jinchengXie99/FOC_v0.1/开发记录日志.md

# 浩盛单路电机开发板 V2.0 硬件驱动与 FOC 控制配置记录

> **文档版本**：V2.0  
> **生成日期**：2026-10-20  
> **MCU 型号**：STM32G431RBT6（LQFP64，170MHz，M4 内核带 FPU）  
> **开发环境**：STM32CubeMX + Keil MDK-ARM  
> **硬件版本**：浩盛单路电机开发板 V2.0

---

## 一、 硬件平台基本信息

| 模块 | 规格说明 |
| :--- | :--- |
| **MCU** | STM32G431RBT6，主频 170MHz，128KB Flash，32KB SRAM |
| **外部晶振** | 16 MHz（HSE） |
| **栅极驱动** | 4 × EG2104（单路 PWM 输入，内部自带互补死区，典型死区 100ns） |
| **功率级** | 4 个半桥（双 H 桥），MOSFET 型号 HYG025N06LS1C2，支持三相/步进电机 |
| **电流采样** | 下桥臂采样，A 相 (R28) 和 C 相 (R29)，采样电阻 **5mΩ** |
| **电流运放** | 外部运放 COS722MR，固定增益 **10 倍**，1.65V 基准偏置 |
| **母线电压** | R83 (100k) 与 R56 (4.7k) 分压，运放隔离，TVS (SMAJ40CA) 在 40V 钳位 |
| **其他外设** | 0.96 寸 SPI 彩屏、三色 LED、两个按键、NTC 测温、KTH7823 磁编码器（预留） |

---

## 二、 引脚分配总表

| 引脚 | 功能 | 外设/信号 | 说明 |
| :--- | :--- | :--- | :--- |
| **PC0** | TIM1_CH1 | PWMA | A 相 PWM，接 EG2104 #1 IN |
| **PC1** | TIM1_CH2 | PWMB | B 相 PWM，接 EG2104 #2 IN |
| **PC2** | TIM1_CH3 | PWMC | C 相 PWM，接 EG2104 #3 IN |
| **PC3** | TIM1_CH4 | PWMD | D 相 PWM（步进用）；同时产生 OC4REF 触发 ADC |
| **PA6** | ADC2_IN3 | 相电流 | 接 COS722MR 输出（具体对应 A/C 相按实物接线） |
| **PA4** | ADC2_IN17 | 相电流 | 接 COS722MR 输出（具体对应 A/C 相按实物接线） |
| **PC5** | ADC2_IN11 | V_BUS | 母线电压采样（**注意：UART1_RX 也是 PC5，当前未启用 RX，无冲突**） |
| **PA0** | GPIO Output | SD4 | EG2104 #4 使能（步进电机 D 桥臂） |
| **PA1** | GPIO Output | SD2 | EG2104 #2 使能（B 相） |
| **PA2** | GPIO Output | SD3 | EG2104 #3 使能（C 相） |
| **PB0** | GPIO Output | SD1 | EG2104 #1 使能（A 相） |
| **PC13** | GPIO Output | LED_B | 蓝色 LED（低电平点亮） |
| **PC14** | GPIO Output | LED_G | 绿色 LED（低电平点亮） |
| **PC15** | GPIO Output | LED_R | 红色 LED（低电平点亮） |
| **PC9** | GPIO Input | KEY1 | 按键 1（上拉，低电平按下，用于故障恢复） |
| **PB12** | GPIO Input | KEY2 | 按键 2（上拉） |
| **PB15** | ADC | TEMP | NTC 温度检测（预留） |
| **PB2** | ADC | ADC_IN | 波轮电位器（预留） |
| **PC4** | USART1_TX | TX | 调试串口发送（DMA） |
| **PC5** | USART1_RX | RX | 调试串口接收（**被母线采样占用，未启用**） |
| **PC10** | SPI3_SCK | SCK | LCD 时钟 |
| **PC12** | SPI3_MOSI | MOSI | LCD 数据 |
| **PA15** | GPIO Output | CS | LCD 片选 |
| **PC11** | GPIO Output | LCD_RST | LCD 复位 |
| **PD2** | GPIO Output | LCD_RS | LCD 数据/命令选择 |
| **PA13/PA14** | SWDIO/SWCLK | 调试 | 调试接口，PA14 不再用于 ADC |
| **PB3/PB4/PB5/PB9** | SPI1 | 预留 | 编码器 KTH7823 接口预留 |

---

## 三、 CubeMX 外设配置说明

### 3.1 系统时钟 (RCC)
*   **HSE**: 16 MHz 晶振
*   **PLLM** = 4, **PLLN** = 85, **PLLR** = 2
*   **SYSCLK** = 170 MHz，AHB/APB1/APB2 均为 /1 分频。

### 3.2 TIM1 (三相 PWM 与 ADC 触发)
*   **Clock Source**: Internal Clock
*   **Prescaler**: 0
*   **Counter Mode**: Center Aligned Mode 1
*   **Period (ARR)**: 4250（PWM 频率 20kHz）
*   **TRGO**: Disable（因为 ADC 直接使用 CH4 比较事件触发）
*   **Channel 1~4**: PWM Generation CH1~CH4，PWM Mode 1，Pulse=0，CH Polarity = High
*   **CH4 特殊配置**：`CCR4 = ARR - 1`，作为 ADC2 的上升沿触发源。
*   **死区配置**：无需配置（EG2104 内部硬件死区）。

### 3.3 ADC2 (电流采样与母线电压)
*   **时钟**：由系统时钟分频，确保不超过 60MHz。
*   **注入组 (Injected, 20kHz)**：
    *   触发源：**Timer 1 Capture Compare 4 event (TIM1_CC4)**，Rising Edge
    *   Rank 1：ADC2_IN3 (PA6)
    *   Rank 2：ADC2_IN17 (PA4)
    *   采样时间：12.5 或 15 cycles
    *   开启 `ADC1_2_IRQn` 中断。
*   **规则组 (Regular, 1kHz 软件触发)**：
    *   触发源：Software Trigger
    *   Rank 1：ADC2_IN11 (PC5，母线电压)
    *   采样时间：47.5 或 92.5 cycles
    *   连续转换模式：Disable

### 3.4 TIM2 (1kHz 控制环)
*   **Prescaler** = 16999，**Period** = 9
*   开启 `TIM2 global interrupt`，优先级低于 ADC 中断。

### 3.5 USART1 (调试串口)
*   **Baud Rate**: 921600
*   **Mode**: Asynchronous (TX only 或开启 RX，但物理引脚不接)
*   **DMA**: 添加 `USART1_TX`，Memory to Peripheral，Normal 模式。

---

## 四、 核心算法与控制逻辑

### 4.1 电流换算公式
*   **增益**：\(I = (ADC\_Value - Offset) \times \frac{3.3}{4096} \times \frac{1}{5m\Omega \times 10}\)
*   **换算系数**：`CURRENT_SCALE = 0.016113 A/LSB`
*   **零点偏置**：`ia_offset ≈ 1991`, `ic_offset ≈ 1971`（需在静止无电流时实测标定）。

### 4.2 母线电压换算公式
*   **分压比**：\(V_{pin} = V_{bus} \times \frac{4.7}{100 + 4.7}\)
*   **换算系数**：`VBUS_SCALE = 0.017947 V/LSB`

### 4.3 EG2104 驱动逻辑
| IN | SD | HO | LO | 半桥状态 |
| :--- | :--- | :--- | :--- | :--- |
| 0 | 0 | 0 | 0 | 全关（禁用） |
| 0 | 1 | 0 | 1 | 下管导通 |
| 1 | 0 | 0 | 0 | 全关（禁用） |
| 1 | 1 | 1 | 0 | 上管导通 |
*   *注意：SD 低电平有效。上电初始化和故障时，必须拉低 SD 引脚。*

### 4.4 保护机制
1.  **过流保护（在 ADC2 中断中执行）**：
    *   **硬阈值**（15.0A）：瞬间超过立即关断，不消抖。
    *   **软阈值**（8.0A）：连续 5 次（50μs 周期）超过才关断，抗噪声。
    *   故障动作：拉低所有 SD 引脚，PWM 占空比清零，红灯亮，锁存故障 `g_fault_latch = 1`。
2.  **过欠压保护（在 TIM2 中断中执行）**：
    *   **过压**：> 30.0V 触发（恢复阈值 29.0V）。
    *   **欠压**：< 10.0V 触发（恢复阈值 12.0V）。
    *   故障动作：同过流保护。
3.  **故障恢复**：需在主循环中判断，电流归零、电压在安全区间内，且按下 KEY1 后，才清除锁存并重新使能 SD 引脚。

### 4.5 上位机通信 (VOFA+ JustFloat)
*   **协议结构**：`typedef struct { float ch_data[N]; uint8_t tail[4]; } VOFA_Frame_t;`
*   **帧尾**：`{0x00, 0x00, 0x80, 0x7F}`。
*   **发送机制**：在 TIM2 (1kHz) 或降频的 ADC2 中断中，检查 `vofa_tx_busy` 标志，空闲时调用 `HAL_UART_Transmit_DMA`。在 `HAL_UART_TxCpltCallback` 中清除忙标志。

---

## 五、 当前进度与后续计划

### 已完成进度：
- [x] 硬件引脚映射与 CubeMX 底层配置。
- [x] 20kHz PWM 产生、ADC2 注入组电流采样、1kHz 规则组电压采样。
- [x] VOFA+ 波形协议打通。
- [x] V/F 开环控制验证成功（电机可转动）。
- [x] 过流、过压、欠压软件保护逻辑实现。
- [x] I/F（电流闭环，频率开环）代码编写。

### 后续开发计划：
1. **I/F 调试**：观察 \(I_d, I_q\) 波形，调整 PI 参数，验证电机输出力矩。
2. **编码器接入**：启用 KTH7823（SPI/ABZ），获取精确电角度与转速。
3. **有感 FOC 闭环**：实现速度环与电流环的双闭环控制。
4. **硬件级保护（可选）**：接入 STM32 内部 COMP 比较器，触发 TIM1 BKIN 硬件刹车，实现微秒级短路保护。
