jinchengXie99/FOC_v0.1/Hardware/tb_image_share_1756172024298.jpg.png

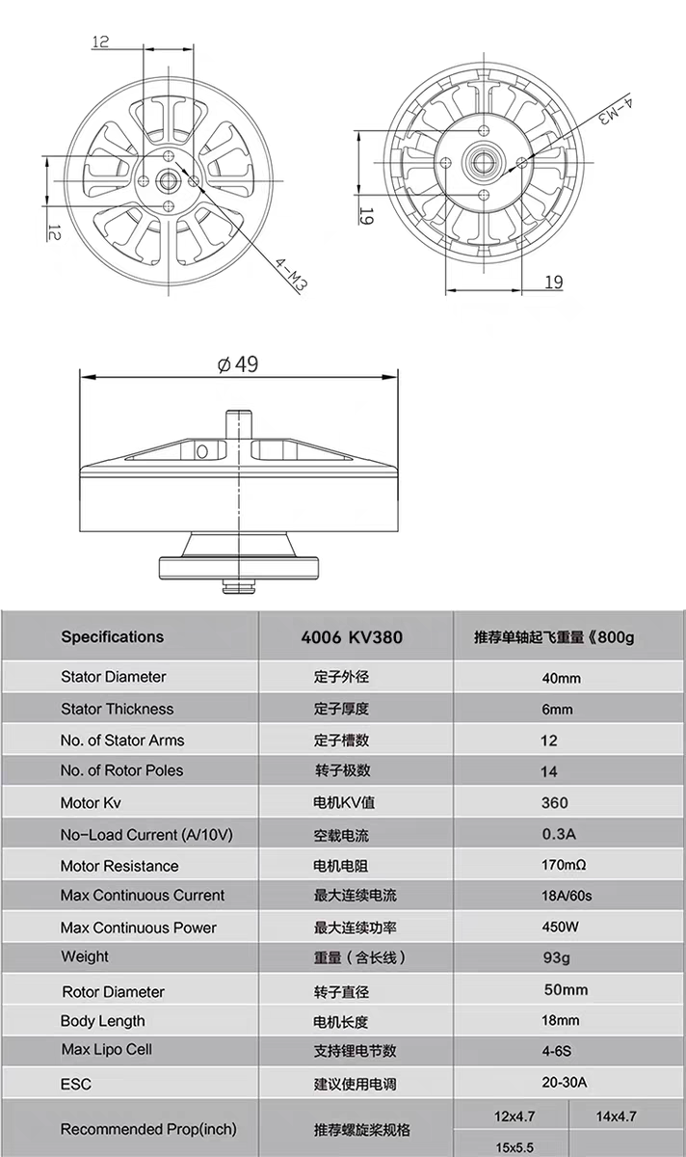
Hardware/tb_image_share_1756172024298.jpg.png
