jinchengXie99/FOC_v0.1/Hardware/浩盛电机开发板支架SLDPRT.SLDPRT

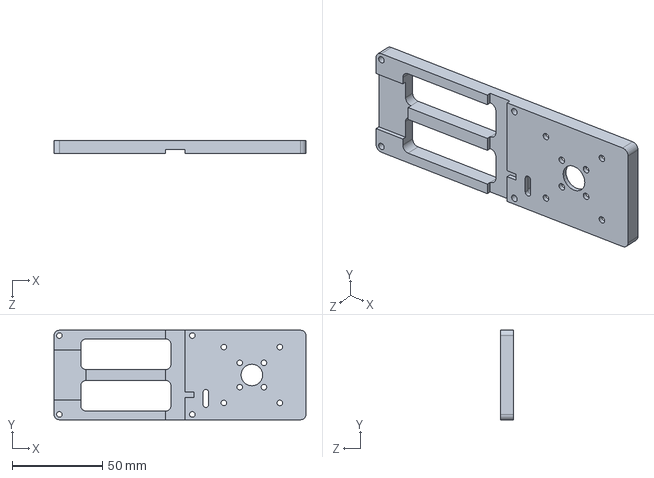
[picture p11: CAD file, 2026-10-22]
Hardware/浩盛电机开发板支架SLDPRT.SLDPRT
139.7 x 49.7 x 7.00 mm
