jinchengXie99/FOC_v0.1/(list of files, drawings)

Other design files:
Hardware/SCH_KTH7823编码器板V1.0.json
Hardware/SCH_浩盛单路电机开发板V2.0.json
