jinchengXie99/FOC_v0.1/FOC_v0.1.ioc

Mcu.UserName=STM32G431RBTx
PA0.GPIO_Label=SD4
PA0.Signal=GPIO_Output
PA1.GPIO_Label=SD2
PA1.Signal=GPIO_Output
PA13.Signal=SYS_JTMS-SWDIO
PA14.Signal=SYS_JTCK-SWCLK
PA2.GPIO_Label=SD3
PA2.Signal=GPIO_Output
PA4.Signal=ADC2_IN17
PA6.Signal=ADC2_IN3
PB0.GPIO_Label=SD1
PB0.Signal=GPIO_Output
PB12.GPIO_Label=KEY2
PB12.Signal=GPIO_Input
PB6.Signal=USART1_TX
PB7.Signal=USART1_RX
PC0.Signal=S_TIM1_CH1
PC1.Signal=S_TIM1_CH2
PC13.GPIO_Label=LED_B
PC13.Signal=GPIO_Output
PC14-OSC32_IN.GPIO_Label=LED_G
PC14-OSC32_IN.Signal=GPIO_Output
PC15-OSC32_OUT.GPIO_Label=LED_R
PC15-OSC32_OUT.Signal=GPIO_Output
PC2.Signal=S_TIM1_CH3
PC3.Signal=S_TIM1_CH4
PC5.Signal=ADC2_IN11
PC9.GPIO_Label=KEY1
PC9.Signal=GPIO_Input
PF0-OSC_IN.Signal=RCC_OSC_IN
PF1-OSC_OUT.Signal=RCC_OSC_OUT
