jinchengXie99/FOC_v0.1/(commit log)

2026-10-16 VF 启动完成 验证完成硬件驱动配置确认无误
2026-10-19 VF控制 补充过欠压 软件过流
2026-10-20 IF控制 闭环成功 电流可跟随
2026-10-21 暂时闭环完成 ，还需调整速度环参数
2026-10-21 优化参数已稳定运行PLL无感观测器
2026-10-22 更改了代码格式和添加了硬件资料
2026-10-23 磁链观测器完成
2026-10-23 尝试调参吸尘器，没成功最高转速29Krpm
2026-10-25 优化了一下观测器参数
2026-10-25 优化了部分参数
2026-10-27 添加弱磁 和 滑动调速
